mokshasoft/hus/finputs-lera.md

# Lergolv och finputs med lera
Process och recept för att göra lerbadrum och lergolv.

## Leran
Det behöver vara en finkorning lera utan för mycket sand och organsiskt material. Kan man inte få tag i det så kan det köpas som lerpulver/lermjöl från tex baramineraler.se. 

## Recept finputs
Läggs som sista lagret i väggar och golv. Kan vara mellan 0,5-1.5 cm.

- 2-5% ej uppvärmd rå linolja, lägre spannet går ok pga av pris.
- kaveldun, i samma mängd som det brukar vara fibrer.

## Recept finfinputs

Ett speciallager som kan användas i badrums ytor som utsätts för mycket vatten. Ett mycket tunt lager som läggs efter finputsen.

- Filtrera en lervälling genom ett finmaskigt såll.

## Process för golvläggningen (förutom badrum)

1. Lägg ett finputslager. Låt härda.
1. Stryk golvet med uppvärmd rå linolja, cirka 80 grader, för att det lättare ska tränga ner i leran. Om temperaturen överstiger 100 polymeriseras oljan och kan då inte trängas ner i leran.
1. Låt härda i 10 dagar.
1. Stryk golver med uppvämd rå linolja.
1. Låt härda i 10 dagar.
1. Slipa med en fyrkantig cementgolvslip. Det gör att sandpartiklar som sticker upp ur ytan försvinner och resultatet blir en väldigt slät yta.
1. Upprepa strykning med uppvärmd rå linolja/härdning 2 ggr.

## Process för golv och vägg i badrum

Gör samma process som för andra golv, och lägg till ett lager finfinputs efter finputslagret. Sedan följande process:

1. Stryk med två lager kokt linolja, med härdning mellan.
1. Stryk ett lager standolja (Standolja är en polymeriserad kokt linolja). Det ger bättre vatten avvisning. Ta ej för mycket eftersom det tar lång tid att torka.
