mokshasoft/hus/gen/hus4.stl

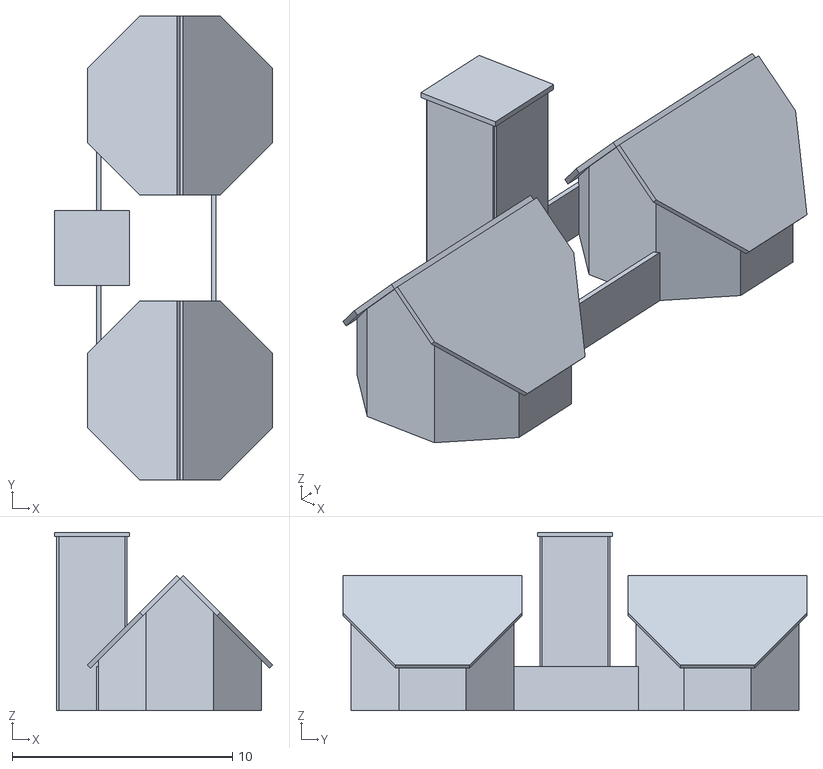
[picture p1: CAD file, 2025-08-23]
gen/hus4.stl
9.91 x 21.1 x 8.10
