mokshasoft/hus/gen/greenhouse1.stl

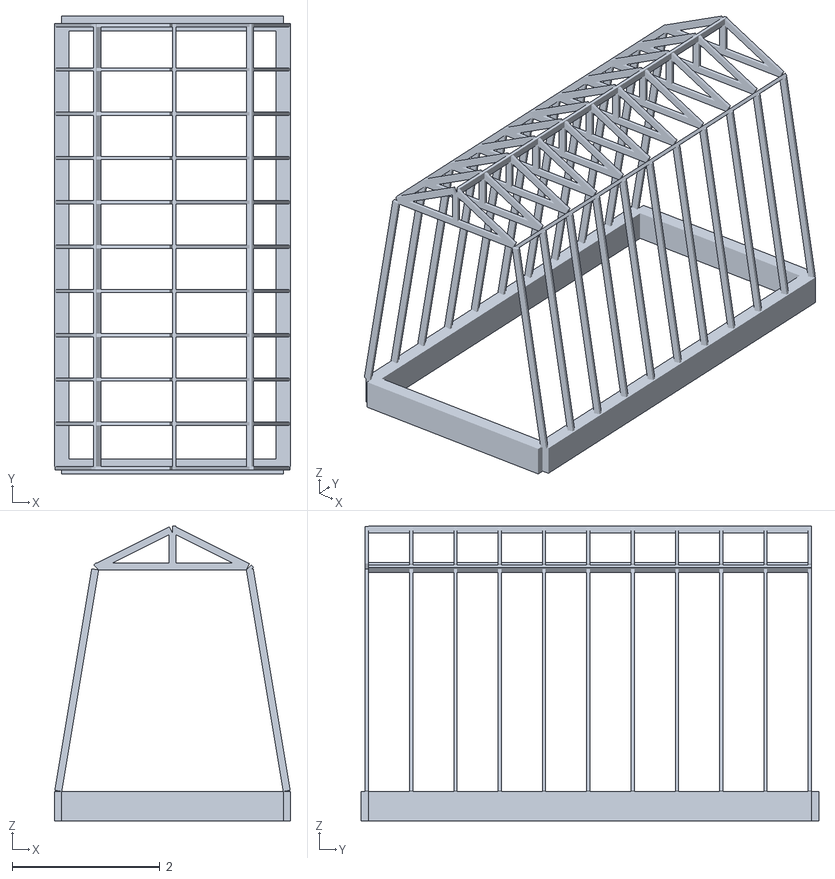
[picture p2: CAD file, 2025-08-23]
gen/greenhouse1.stl
3.20 x 6.20 x 4.00
