mokshasoft/hus/gen/hus5.stl

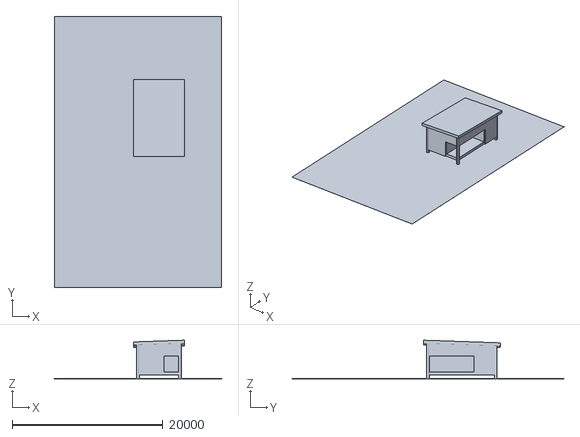
[picture p3: CAD file, 2025-08-23]
gen/hus5.stl
22249.2 x 36000.0 x 5137.5
