mokshasoft/hus/gen/hus6.stl

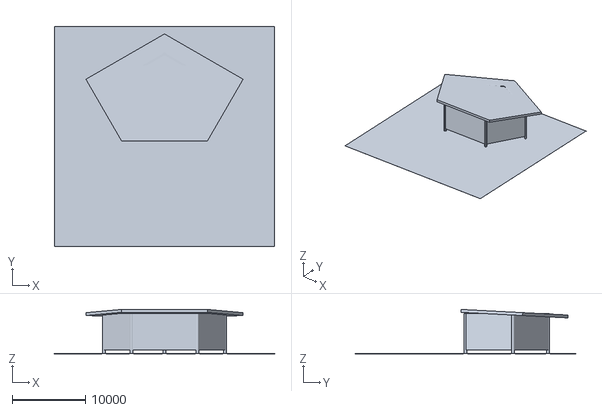
[picture p4: CAD file, 2025-08-23]
gen/hus6.stl
30080.0 x 30080.0 x 6042.1
