mokshasoft/hus/gen/guesthouse1.stl

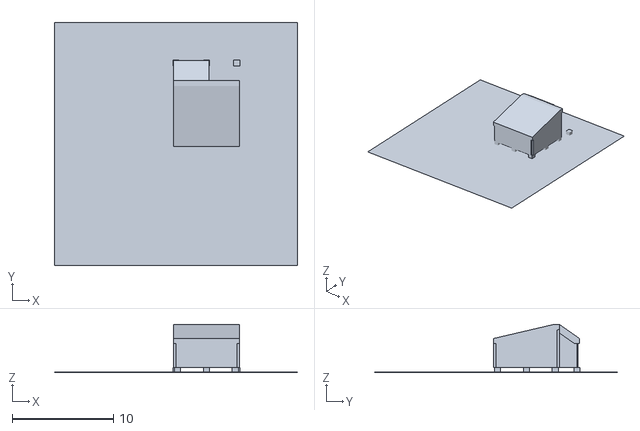
[picture p5: CAD file, 2025-08-23]
gen/guesthouse1.stl
24.0 x 24.0 x 4.77
