mokshasoft/hus/gen/greenhouse2.stl

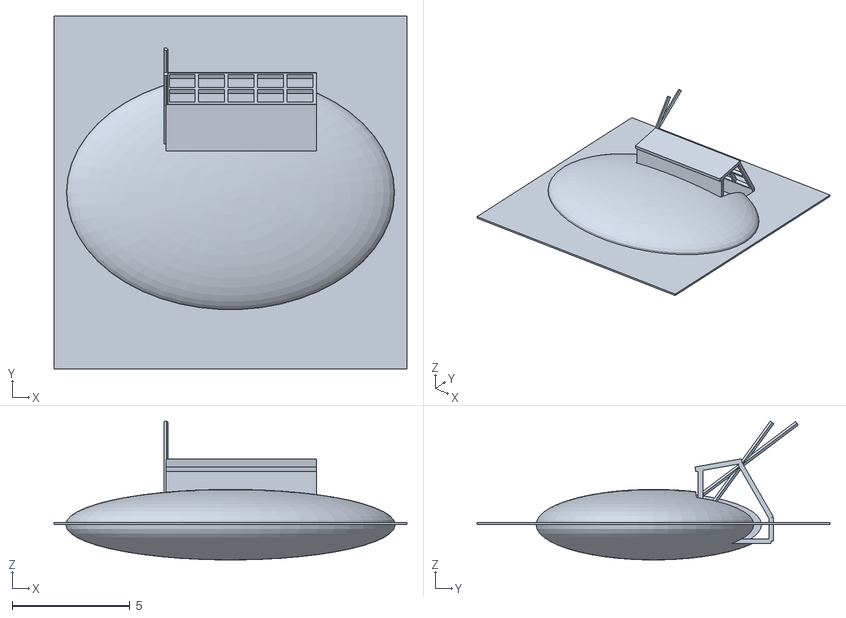
[picture p6: CAD file, 2025-08-23]
gen/greenhouse2.stl
15.0 x 15.0 x 5.90
