mokshasoft/hus/gen/hylla-kontor.stl

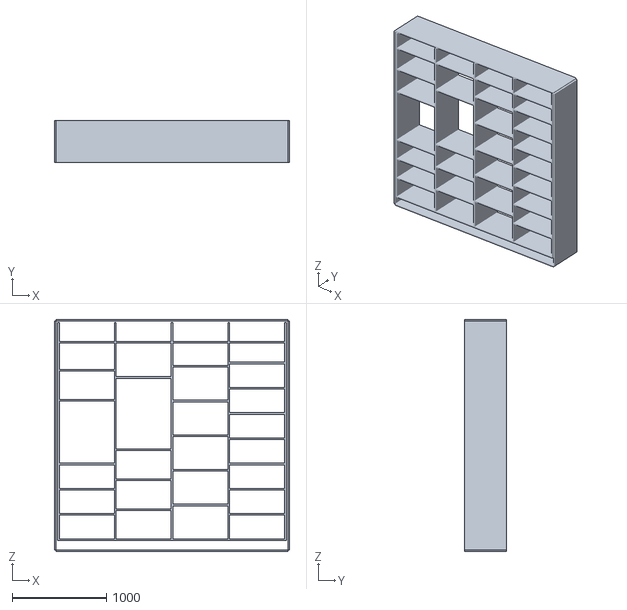
[picture p7: CAD file, 2025-03-01]
gen/hylla-kontor.stl
2496.0 x 450.0 x 2466.0
