mokshasoft/hus/gen/hus8.stl

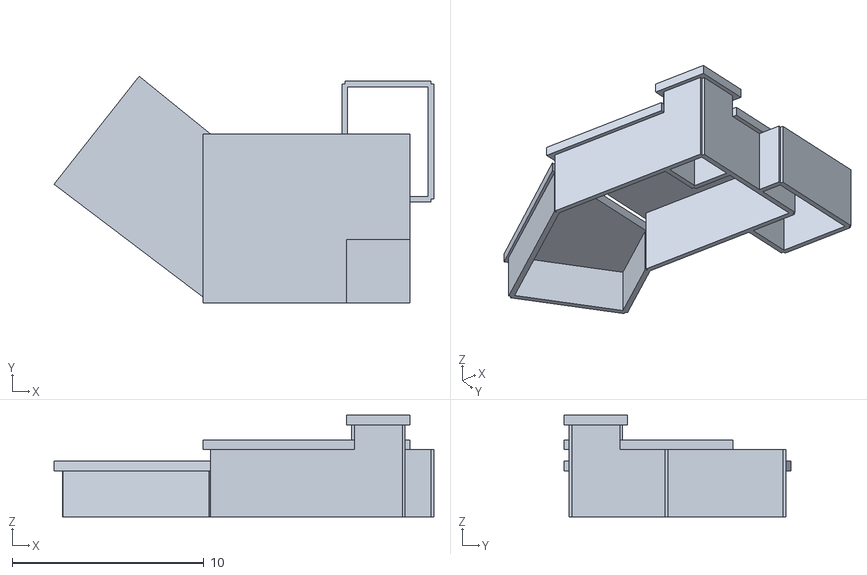
[picture p8: CAD file, 2021-03-17]
gen/hus8.stl
19.8 x 11.8 x 5.30
