mokshasoft/hus/gen/hus7.stl

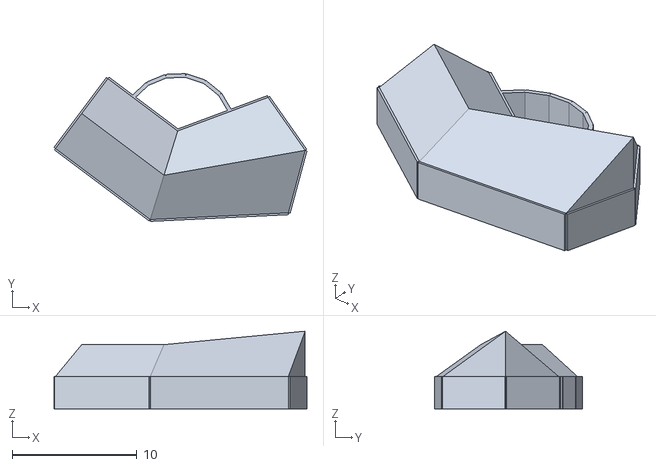
[picture p9: CAD file, 2020-10-30]
gen/hus7.stl
20.3 x 11.9 x 6.23
