mokshasoft/hus/gen/guesthouse2.stl

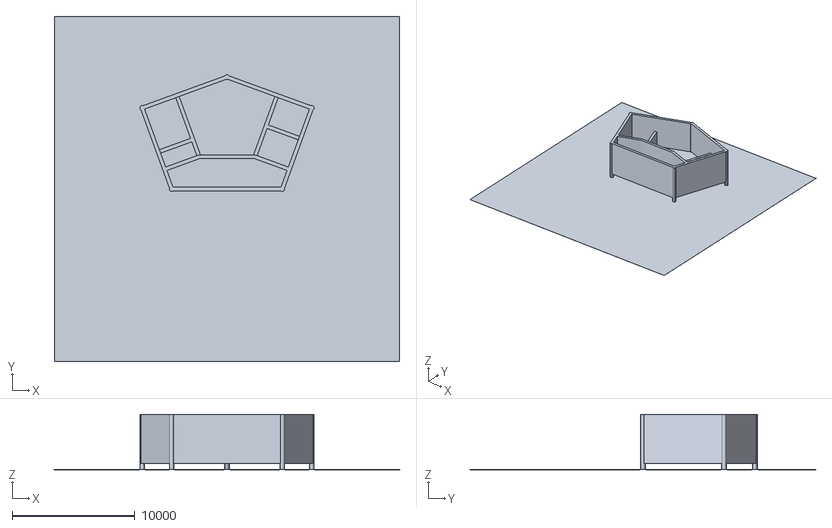
[picture p10: CAD file, 2020-05-02]
gen/guesthouse2.stl
28080.0 x 28080.0 x 4502.0
