mokshasoft/hus/gen/hus3.stl

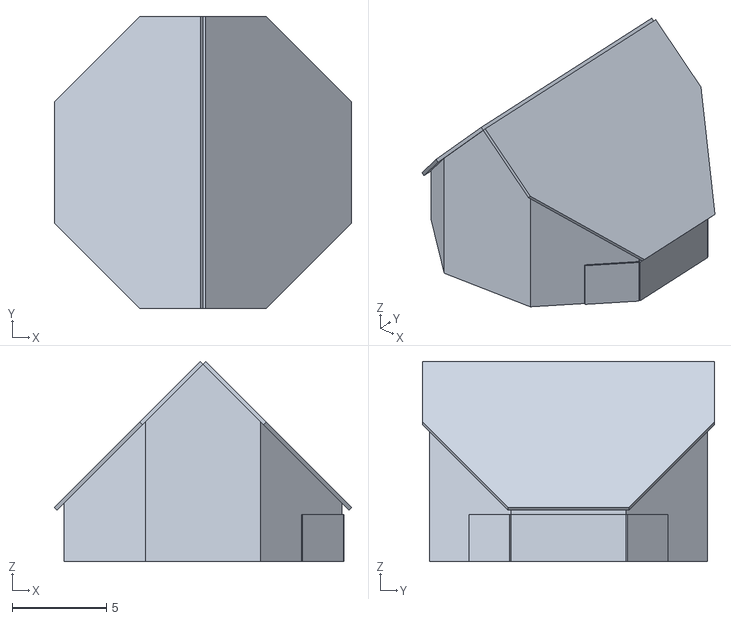
[picture p11: CAD file, 2019-09-15]
gen/hus3.stl
15.8 x 15.5 x 10.6
