mokshasoft/hus/gen/hus1.stl

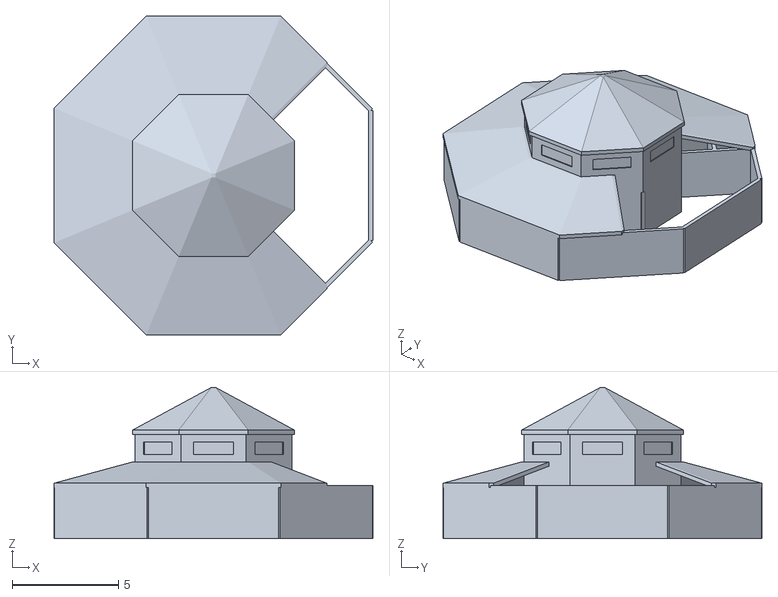
[picture p12: CAD file, 2019-09-15]
gen/hus1.stl
15.0 x 15.0 x 7.10
