mokshasoft/hus/gen/hus2.stl

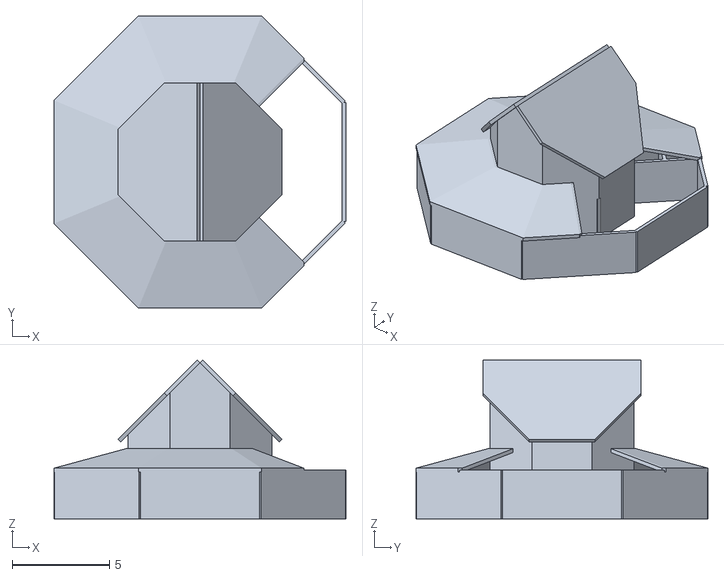
[picture p13: CAD file, 2019-09-15]
gen/hus2.stl
15.0 x 15.0 x 8.14
