mokshasoft/hus/gen/plan1_2.stl

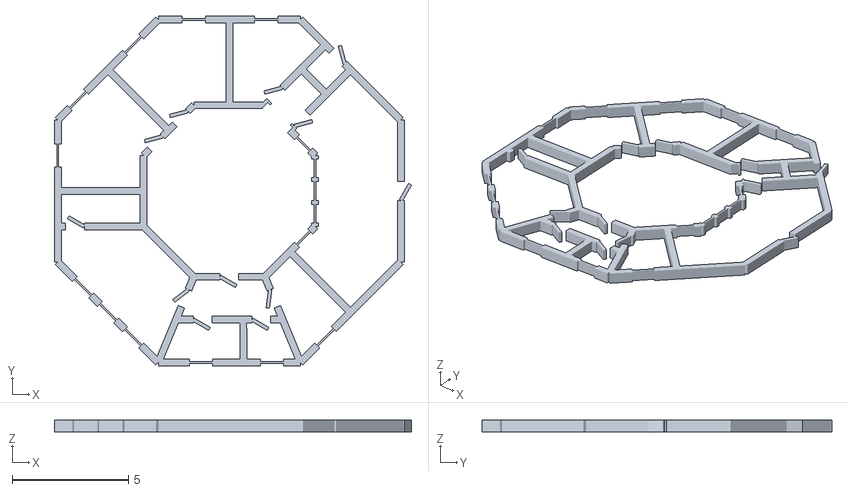
[picture p14: CAD file, 2019-09-12]
gen/plan1_2.stl
15.4 x 15.1 x 0.5
