mokshasoft/hus/gen/plan1_1.stl

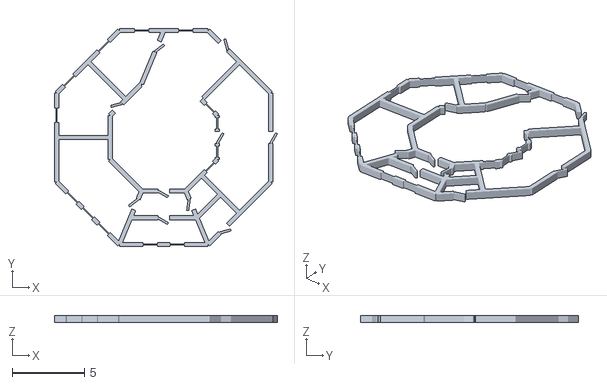
[picture p15: CAD file, 2019-09-12]
gen/plan1_1.stl
15.4 x 15.1 x 0.5
