mokshasoft/hus/gen/utan-tak.stl

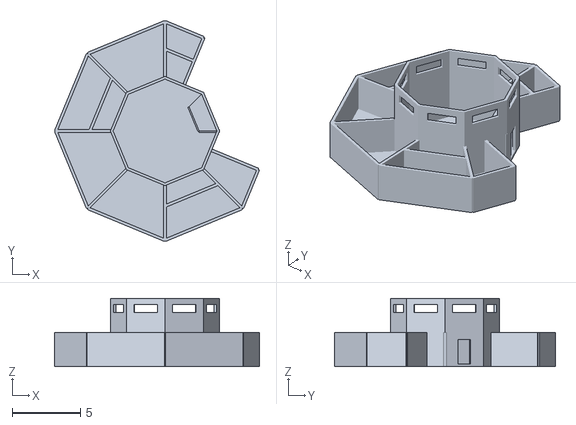
[picture p16: CAD file, 2019-09-09]
gen/utan-tak.stl
15.0 x 16.2 x 5.00
