mokshasoft/hus/(list of files, cad)

Other CAD files:
hus1-plan.scad
hus2.scad
hus3.scad
plan1_1.scad
