mokshasoft/hus/Elements/ChangeLog.md

# Changelog for Elements

## Unreleased changes
