mokshasoft/hus/(commit log)

2019-09-08 The basic structure of the house
    [hus1.scad]
2019-09-08 Add windows to main room
    [hus1.scad]
2019-09-08 Add glass to windows
    [hus1.scad]
2019-09-08 Create hole for front door
    [hus1.scad]
2019-09-08 Make the roof in the main room sloping
    [hus1.scad]
2019-09-08 Slope the outer roof
    [hus1.scad]
2019-09-08 Slope the left and right outer roofs
    [hus1.scad]
2019-09-09 The first room design
    [hus1.scad]
2019-09-09 Add generated stl files
    [med-tak.stl, utan-tak.stl]
2019-09-10 Create the start of the first floor plan
    [plan1.scad]
2019-09-10 Add final doors to first plan of house 1
    [plan1.scad]
2019-09-10 Fixed rendering problem in glas wall of winter garden
    [plan1.scad]
2019-09-11 Add more windows to plan1
    [plan1.scad]
2019-09-12 Add second floor plan example
    [hus1-plan.scad, plan1_1.scad, plan1_2.scad]
2019-09-12 Generate stl files instead of png files for floor plan
    [plan1_1.stl, plan1_2.stl]
2019-09-12 Add windows to bathrooms
    [plan1_2.scad, plan1_2.stl]
2019-09-14 Create and use a window module
    [hus1.scad]
2019-09-15 Add a house with a 45 degree slooping roof towards the south
    [hus1.stl, hus2.scad, hus2.stl]
2019-09-15 Removed med-tak.stl
    [med-tak.stl]
2019-09-15 Add start of third house model
    [hus3.scad, hus3.stl]
2019-09-19 Broke out wall creation etc to element.scad
    [element.scad, hus1.scad]
2019-09-19 Use element.scad for hus2 and hus3
    [hus2.scad, hus3.scad]
2019-09-19 Assemble the house in two modules
    - One for the house
    - One for the interior
    [hus1.scad]
2019-09-19 Broke out the glas color to element.scad and changed it to lightblue
    [element.scad, hus1.scad, hus2.scad, hus3.scad]
2019-09-19 Use mirror instead of writing two mirrored models
    [hus1.scad]
2020-03-19 Start the fourth house
    [hus4.scad]
2020-03-19 Create the left and right side of house 4
    [hus4.scad]
2020-03-19 Add central walls
    [hus4.scad]
2020-03-19 Add a tower to the house
    [hus4.scad]
2020-04-12 Add two guesthouses
    [element.scad, guesthouse.scad, guesthouse2.scad]
2020-04-13 Make colors into modules
    [element.scad, guesthouse2.scad]
2020-04-13 Use the standard colors for the first guesthouse
    [guesthouse.scad]
2020-04-13 Add colors to second house
    [hus2.scad]
2020-04-13 Add colors to house one
    [hus1.scad]
2020-04-16 Make guesthouse2 slightly larger
    [guesthouse2.scad]
2020-04-16 Add area calculations to guesthouse2
    [area.scad, guesthouse2.scad]
2020-04-18 Rearrange inner walls
    [guesthouse2.scad]
2020-04-18 Add loft area calculation
    [guesthouse2.scad]
2020-04-21 Add length measurements to guesthouse2
    [guesthouse2.scad, measurement.scad]
2020-04-26 Measure other lengths on guesthouse in order to be able to stake it out
    [guesthouse2.scad]
2020-05-02 Add stl file of guesthouse2
    [guesthouse2.stl]
2020-05-03 Create floorplan for guesthouse2
    [floorplan.scad, guesthouse2-plan.scad]
2020-05-04 Increase the size of guesthouse2
    [guesthouse2.scad]
2020-05-04 Use the configuration of guesthouse2 in the floorplan
    [guesthouse2-plan.scad]
2020-05-04 Make the inner walls thinner on guesthouse2
    [guesthouse2-plan.scad]
2020-05-04 Make the hall 2m's wide in guesthouse2
    [guesthouse2-plan.scad, guesthouse2.scad]
2020-05-04 Add material calculations for guesthouse2
    [guesthouse2.scad]
2020-10-10 Move helper files to lib
    [guesthouse.scad, guesthouse2.scad, hus1.scad, hus2.scad, hus3.scad, hus4.scad]
2020-10-26 Starting the 7th house
    [hus7.scad]
2020-10-27 Remove hard-coding of corners in 7
    [hus7.scad]
2020-10-27 Print the south angle
    [hus7.scad]
2020-10-27 Open up the south angle a bit
    [hus7.scad]
2020-10-27 Calculate volume of insulation of 7
    [hus7.scad]
2020-10-27 Remove unused code in 7
    [hus7.scad]
2020-10-27 Add winter garden
    [hus7.scad]
2020-10-27 Make more space in left side
    [hus7.scad]
2020-10-27 Make right side shorter to make the house smaller
    [hus7.scad]
2020-10-27 Remove unused code
    [hus7.scad]
2020-10-27 Make 7 a floor plan
    [hus7.scad]
2020-10-28 Add calculation of winter garden area
    [hus7.scad]
2020-10-30 Remove incorrect glas_color
    [hus2.scad, hus3.scad, hus7.scad]
2020-10-30 Add beams for the top of the roof
    [hus7.scad]
2020-10-30 Add the roof
    [hus7.scad]
2020-10-30 Remove the beams
    [hus7.scad]
2020-10-30 Lower the roof angle
    [hus7.scad]
2020-10-30 Add height of the lower roof-ridge
    [hus7.scad]
2020-10-30 Place the highest roof ridge in the correct spot
    [hus7.scad]
2020-10-30 Add walls up to the roof-ridge
    [hus7.scad]
2020-10-30 Add measurement of roof-ridge heights
    [hus7.scad]
2020-10-30 Add more scad files to stl target
2020-10-30 Add hus7 stl
    [hus7.stl]
2020-11-27 Remove the ridge on the roof in house 7
    [hus7.scad]
2020-11-28 Change roof angle to 10 degrees
    [hus7.scad]
2021-03-17 Copied hus7
    [hus8.scad]
2021-03-17 Start on hus8
    [hus8.scad]
2021-03-17 Add tea room roof
    [hus8.scad]
2021-03-17 Add lower roof
    [hus8.scad]
2021-03-17 Add the living room roof
    [hus8.scad]
2021-03-17 Add stl for hus8
    [hus8.stl]
2021-08-20 Start a model of the guesthouse
    [guesthouse1.scad]
2021-08-21 Add foundation on guesthouse
    [guesthouse1.scad]
2021-08-21 Parameterize where plinths are places in guesthouse
    [guesthouse1.scad]
2021-08-22 Add foundation for the south patio
    [guesthouse1.scad]
2021-08-22 Add outer roof
    [guesthouse1.scad]
2021-12-09 Start on the garage
    [garage1.scad]
2021-12-14 Add roof and trellis walls
    [garage1.scad]
2021-12-14 Add flat walls
    [garage1.scad]
2021-12-14 Triangle walls and color
    [garage1.scad]
2021-12-14 Add more color
    [garage1.scad]
2021-12-14 Configure log diameter
    [garage1.scad]
2021-12-15 Make garage more parameterized
    [garage1.scad]
2021-12-15 Start on the greenhouse
    [greenhouse1.scad]
2021-12-15 Add lengthwise beams
    [greenhouse1.scad]
2021-12-15 Moved configuration to top
    [greenhouse1.scad]
2022-01-02 Add greenhouse truss
    [greenhouse1.scad]
2022-01-28 Add foundation
    [foundation.scad]
2022-04-03 Add roof length calculation
    [garage1.scad]
2022-04-03 Add modules used to calculate material amounts
2022-04-05 Start a material calculation
2022-04-06 Add the rest of the framed walls
2022-04-06 Print lengths of all materials
2022-04-07 Redo the foundation with natural stones
    [foundation.scad]
2022-04-07 Remove hard coding of outer size
    [foundation.scad]
2022-04-07 Add log foundation
    [foundation.scad]
2022-04-07 Change color
    [foundation.scad]
2022-04-07 Create the floor framework
    [foundation.scad]
2022-04-08 Do not buy material for the winter garden and garage for now
2022-04-24 Add material for floor framework
2022-08-25 Fix a length measurement on the garage
    [garage1.scad]
2023-01-22 OpenSCAD stove test
    [compose.scad, stove1.scad]
2023-01-22 Add more stove composers
    [compose.scad, stove1.scad]
2023-01-31 Use correct brick sizes
    [compose.scad, stove1.scad]
2023-02-09 Tried some stove things
    [compose.scad, stove1.scad]
2023-05-21 hindent Materials
2023-10-27 Started the rocket stove design
    [rocket-stove.scad]
2023-12-13 Update materials for carport
2024-04-10 Test a new house shape
    [hus9.scad]
2024-04-11 Achieve golden ratio with 10 sides
    [hus9.scad]
2024-04-11 Find height for 11 sides
    [hus9.scad]
2024-04-14 Parameterize the number of floors
    [hus9.scad]
2024-04-14 Pass params to floor
    [hus9.scad]
2024-05-30 Skapa spaljen
    [spalje.scad]
2024-09-19 Calculate coordinates for trellis
    [spalje2.scad]
2025-01-04 Start bed design
    [bed.scad]
2025-01-04 Add bed feet
    [bed.scad]
2025-01-04 Bed done
    [bed.scad]
2025-01-05 Add floor
    [hus9.scad]
2025-01-05 Add log of bed materials
    [bed.scad]
2025-01-05 Testing different trellis configs
    [spalje2.scad]
2025-01-08 Start designing the office shelf
    [hylla-kontor.scad]
2025-01-08 Fixing off-by-one error in shelf
    [hylla-kontor.scad]
2025-01-14 Set outer dim on shelf
    [hylla-kontor.scad]
2025-01-27 List comprehend shelves
    [hylla-kontor.scad]
2025-01-27 Move width to top-level
    [hylla-kontor.scad]
2025-01-27 Make the correct width
    [hylla-kontor.scad]
2025-01-27 Add opening
    [hylla-kontor.scad]
2025-01-27 Make shelf columns uniform and parameterized
    [hylla-kontor.scad]
2025-01-27 Create base
    [hylla-kontor.scad]
2025-01-27 Move bottom shelf to base
    [hylla-kontor.scad]
2025-01-27 Make shelves correct width
    [hylla-kontor.scad]
2025-01-27 Add top shelf height
    [hylla-kontor.scad]
2025-01-29 Accumulate shelf positions
    [hylla-kontor.scad]
2025-01-29 Design done
    [hylla-kontor.scad]
2025-01-29 Print number of planks
    [hylla-kontor.scad]
2025-02-03 First spa concept
    [spa.scad]
2025-02-03 Try fixing rendering
    [spa.scad]
2025-02-04 Simplify roof
    [spa.scad]
2025-03-01 Hylla stl
    [hylla-kontor.stl]
2025-03-09 Finish shelf design
    [hylla-kontor.scad]
2025-03-09 Add functions that print measurments
    [hylla-kontor.scad]
2025-03-09 Print measurment in model
    [hylla-kontor.scad]
2025-05-15 Use 15 sticks
    [bed.scad]
2025-08-19 Create a second greenhouse
    [greenhouse2.scad]
2025-08-20 Done with greenhouse2 concept
    [greenhouse2.scad]
2025-08-23 Try with 5 windows
    [greenhouse2.scad]
2025-08-23 Generate a few more stl:s
    [greenhouse1.stl, greenhouse2.stl, guesthouse1.stl, hus4.stl, hus5.stl, hus6.stl]
2026-04-13 Lägg till OpenSCAD-modell av huset
    Modulär modell med pulpettak (11°), inglasad veranda
    och takutskjut (50 cm hus, 20 cm veranda).
    [house.scad]
2026-04-13 Lägg till terrass med trappsteg
    Terrass på västra sidan med 19 plankor (2x8), förbindelse
    till verandan, samt trappsteg söderut med tre nivåer och
    sättsteg mellan nivåerna.
    [house.scad]
2026-04-13 Lägg till staket på terrassens västra och norra sida
    Svart staket i 2x2 med 2x4 räcke ovanpå. Låg del (1.1 m)
    med 10 cm öppning, hög del (2.2 m) med halva cc-avståndet.
    Övergång 3 meter från norr.
    [house.scad]
2026-04-13 Uppdatera färger till organowood och bränt trä
    Huset och terrassen i ljus silvergrå organowood-färg,
    staketet i mörkbrun bränt trä-färg.
    [house.scad]
2026-04-13 Lägg till variabel för att växla staketets höga del
    railing_high_horizontal styr om den höga delen har
    liggande (true) eller stående (false) reglar.
    [house.scad]
2026-04-13 Ändra räcket till 2x4 dimension
    Räcket ovanpå staketet är nu 100mm brett (4 tum)
    istället för 50mm, centrerat över stolparna.
    [house.scad]
2026-04-13 Lägg till variabler för stolparnas längd under terrassen
    railing_below_west och railing_below_north styr hur
    långt stolparna sträcker sig under terrassnivån.
    Båda satta till 60 cm.
    [house.scad]
2026-04-22 Lägg till skiss av vedskjul med parametriserat pulpet-tak
    Bygger 10x1,5 m vedskjul av 2x8 med parametrar för längd, djup,
    antal sektioner, vägghöjd, takvinkel och takutsprång. Hörnen har
    V-stolpar och sektionsavdelare T-stolpar, alla med höjder anpassade
    efter takets lutning. En kanonisk tum2x8-modul skriver ECHO-rader
    som kan parsas fram till en virkeslista.
    [vedskjul.scad]
2026-05-03 Logga åtgång av 2x2 till räcket
    [house.scad]
2026-05-03 Omarbeta vedskjulet: 6 sektioner á 1,5 m, ta bort takläkten
    Lägg också till echo för fri höjd fram/bak och golvhöjd.
    [vedskjul.scad]
2026-07-27 Bygg om räcket med bärande 2x4-stolpar och räcke på trappan
    Räcket bestod tidigare bara av jämnt utspridda 2x2. Nu delas varje sträcka
    in i fack med bärande 2x4-stolpar emellan, och räcket fortsätter ner för de
    två lägre trappstegen.
    - Ny modul railing_section() som delar en sträcka i fack. Antalet fack väljs
    så att facklängden hamnar närmast önskad, sedan justeras öppningen så att
    sektionen går jämnt ut — inga kapade halvfack i änden.
    - 2x4-stolparna är vridna 90°, dvs 100 mm tvärs räcket och 50 mm längs, och
    centreras över 2x2-linjen i liv med den liggande handledaren.
    - 2x4 sitter i början, vid övergången låg/hög, i det höga hörnet och mot
    h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
    [house.scad]
2026-07-27 Lägg till räcke på trappans östra kant
    Trappstegen går från terrassens västra kant ända fram till verandans östra
    vägg, men bara västra kanten hade räcke. Östra kanten speglas nu kring
    trappans mittlinje, x -> step_mirror_dx - x.
    Östsidan har tre nivåer i stället för två: terrassens sydkant är lika djup
    som ett trappsteg (620 mm, tre plankor) och får ett eget räcke via samma
    railing_step(). I väster täcks den nivån av terrassräckets låga del, som
    fortsätter norrut. Handledaren där avslutas mot verandans södra vägg.
    Bottenregeln ritas också på östsidan, eftersom det inte finns någon
    genomgående sådan att ansluta till där.
    [house.scad]
2026-07-27 Rita utbyggnaden i sydöstra hörnet
    Byggnaden går ut 1,7 m åt öst på sydöstra sidan, 3,1 m i nord-sydlig
    riktning (husets djup minus 5,2 m) räknat från södra väggen.
    Taket ligger i samma plan som huvudtaket och har samma utsprång på de tre
    exponerade sidorna. I väster går det rakt in till house_width, där det möter
    huvudtakets utsprång — ytorna är koplanära så överlappet syns inte.
    Takplanet är utbrutet i funktionen roof_z(y), så att utbyggnadens tak och
    väggarnas överkant inte kan hamna ur liv med huvudtaket.
    [house.scad]
2026-07-27 Lägg till terrass öster om huset, norr om utbyggnaden
    Terrassen fyller den tomma delen av L-et: x 10,2 till 11,9 och y 3,1 till
    8,3, alltså 1,7 x 5,2 m. Plankorna går i nord-sydlig riktning med 2x8 som
    på västsidan, och ovansidan ligger på samma nivå, z = 1,05.
    Bredden är låst av utbyggnaden till 1700 mm, vilket inte går jämnt upp med
    200 mm-plankor och 10 mm mellanrum. Mellanrummet justeras därför till
    14,3 mm så att 8 plankor fyller bredden exakt, i stället för att lämna en
    30 mm stump vid kanten.
    [house.scad]
2026-07-27 Lägg till räcke på östra terrassen
    Tre sektioner: en 50 cm stump norrut från utbyggnadens vägg längs östra
    kanten, norra kanten från husets nordöstra hörn och österut, samt östra
    kanten 3 m söderut från hörnet. Mellan de två östra blir det en 1,7 m
    öppning. Hörnstolpen hör till östra sektionen, den norra går fram till den.
    Ett fast antal 2x2 per fack fungerar inte här: åtta 50 mm-stolpar fyller
    exakt de 400 mm som finns i halvmeterstumpen och ger noll öppning. Ny
    railing_section_fit() räknar därför ut antalet från fackets bredd, vilket
    ger 100,0 / 97,5 / 107,5 mm mot terrassräckets 91,0 mm.
    [house.scad]
2026-07-27 Lägg till trappa från östra terrassen, dimensionerad efter trappformeln
    Trappan ligger i öppningen mellan räckessektionerna på östra terrassen och
    går ner till marken. Planstegen är 2x8, ett per steg.
    Dimensionerad efter trappformeln, 2 x stighöjd + steg = 600-640 mm, i
    stället för att kopiera lutningen från trappan i söder. Den gav 200 mm steg
    med 95 mm stigning, alltså summan 390 mm — långt under intervallet och
    obekvämt att gå i.
    Antalet 2x8 per plansteg är den enda fria variabeln eftersom brädbredden är
    given, och styrs av stair_east_boards. Med 1 bräda blir det 4 plansteg,
    210 mm stigning, 46,4 grader och summan 620 mm. Med 2 brädor blir det
    9 plansteg, 105 mm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
    [house.scad]
2026-07-27 Lägg till räcke på båda sidor om trappan
    Handledaren är en 2x4 roterad kring sin övre ände, så att undersidan ligger
    railing_height_low lodrätt över gånglinjen hela vägen ner. Roteras den kring
    sin egen axel i stället blir höjden mätt vinkelrätt mot lutningen, vilket ger
    för låg höjd. 2x2 står lodrätt mellan gånglinjen och handledaren och blir
    därför lika långa allihop.
    Överst behövs ingen ny stolpe: terrassräckets ändstolpe står redan där och
    dess topp ligger på samma höjd som handledarens övre ände.
    Rättar också två fel i materiallistan: den lutande handledaren räknades som
    bottenregel, och trappräckets 2x2 saknades helt i kaplistan. Summorna
    stäm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
    [house.scad]
2026-07-27 Skjut ut trappan österut och lägg till ramp från norr
    Trappan är parallellförskjuten en bit österut och glappet fylls av en
    utskjutande terrassdel — en tunga lika bred som räckesöppningen. Tungan läggs
    med samma plankdelning som resten av östra terrassen, så utskjutet följer av
    antalet plankor i stället för tvärtom; annars hade tungan fått ett eget
    mellanrum och delningen brutit mot däcket innanför. Fem plankor ger 1,071 m,
    alltså ungefär den meter som var önskemålet.
    Rampen ligger i remsan närmast öster om terrassens ursprungliga kant och går
    från marken vid husets nordvägg upp till tungans norra kant. Lutningen följer
    av utrymmet i stället för tvärtom: det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
    [house.scad]
2026-07-27 Revert "Skjut ut trappan österut och lägg till ramp från norr"
    Designen sparas i historiken men tas ur modellen igen — den blev inte som
    tänkt. Den mesta orsaken är lutningen: kravet att rampen ska hålla sig innanför
    husets nordvägg lämnar bara 3 m åt 1,05 m fallhöjd, och 1:2,86 är för brant för
    att rampen ska göra den nytta den var tänkt att göra.
    Vill man ta upp tråden igen ligger den i f625eee. Det som behöver lösas först
    är var de saknade metrarna ska tas ifrån: låta rampen passera nordväggen,
    vika den med vilplan, eller dra tungan söderut så rampen får hela husdjupet.
    This reverts commit f625eee.
    [house.scad]
2026-07-28 Lägg till tak över östra terrassen
    Taket går från utbyggnadens norra vägg och norrut, en halvmeter under
    takutskjutet ovanför, och lutar med husets taklutning fast mot norr.
    Utskjutet österut är lika långt som på resten av byggnaden och i norr
    sticker det ut 30 cm förbi stolpen som bär det fria hörnet.
    Stommen är 2x6: fem takreglar i fallets riktning, väggregel mot
    utbyggnaden och bärlina över stolpen, båda utkragade i östra kanten.
    Ovanpå ligger en takskiva på 22 mm, och stolpen är 6x6.
    Räcket längs östra kanten slutar nu mot takstolpen i stället för att
    gå 3 meter söderut, så trappöppningen sträcker sig ända fram dit.
    Räcket på östra terrassen står d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
    [house.scad]
2026-08-04 Dra bottenregeln på trappans östra sida ända fram till väggen
    Regeln slutade vid deck_south_y + railing_big_along, dvs 5 cm in på
    översta nivån, så stolpfötterna i den sektionen stod i luften. Nu går den
    ända till verandans södra vägg, precis som den genomgående regeln i väster
    går till husväggen.
    [house.scad]
2026-08-04 Räkna ut hur många hela längder virke som går åt
    Kaplistan säger hur många bitar som behövs, men virket köps i hela
    längder. Packar bitarna med first fit decreasing och skriver ut
    kapmönstren, antal längder och spill. Bitar längre än en hel längd delas
    upp i hela längder plus en stump — de måste skarvas ändå.
    Med 4,8 m-virke: 75 st 2x2 och 20 st 2x4.
    [house.scad]
2026-08-05 Vänd golvytan i huset och utbyggnaden åt rätt håll
    Golvet var vänt tvärtemot formernas fem övriga ytor, så polyhedern aldrig
    blev sluten. Det gav de två "mesh is not closed"-felen vid rendering, och
    gjorde att difference() mot formerna returnerade tomt — vilket märks först
    nu när väggarna ska gröpas ur. Takplattorna i filen använder redan
    [3,2,1,0] för undersidan; golvet var det som avvek.
    [house.scad]
2026-08-05 Sätt in fönster i husmodellen
    Måtten i window_list är hålets mått i väggen. Fönstret görs 15 mm mindre
    runt om, och glaset ligger 50 mm innanför karmens ytterkant. Karmens
    yttermått och glasets fria mått räknas fram och skrivs ut i konsolen som
    underlag för beställning.
    Huset var en solid kloss utan väggtjocklek, så det finns inget hål att
    sätta ett fönster i. Väggen är nu 550 mm och huset gröps ur, på samma
    sätt som porch() redan gjorde.
    Fönstren som ligger i listan är platshållare tills riktiga mått finns.
    render(convexity) på väggarna behövs för snabbpreviewen: den ritar
    difference() med djuptest och måste veta hur många ytor en blick korsar.
    Utan det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
    [house.scad]
2026-08-05 Lägg bjälklaget i liv med terrassen
    Golvet låg tidigare med ovansidan 0,55 m över mark, en halvmeter under
    terrassen, så man hade fått kliva ner för att gå in. Nu ligger färdigt golv
    på deck_top_z och man går rakt ut. Huskroppens yttre form är oförändrad —
    det är hålrummet som börjar högre upp, så bjälklaget hamnar mellan 0,50 och
    1,05 m och det som blir kvar under det är grund.
    house_floor_z definieras vid deck_top_z och inte bland väggparametrarna,
    eftersom terrassmåtten kommer först där i filen.
    [house.scad]
2026-08-05 Vita fönsterkarmar och fönsterhöjder över färdigt golv
    Karmen fick en egen färg i stället för att dela fasadens organowood.
    Höjden i window_list räknas nu från färdigt golv i stället för från mark,
    vilket är så fönsterhöjder brukar anges. window_place lägger på
    house_floor_z, så platshållarna är tillbaka på 0,9 respektive 1,1 m —
    samma läge som förut, mätt från den nya referensen.
    [house.scad]
2026-08-05 Lägg in nordfasadens tre första fönster med riktiga mått
    Fasadritningen ses utifrån, så "höger" i vyn är västra gaveln, x = 0.
    n_x() räknar om det uppmätta avståndet till hålets högra kant till den
    mittlinje som window_list vill ha, så måtten står kvar som de mättes.
    Fönstren placeras relativt varandra i stället för med varsitt absolutmått:
    det övre av paret utifrån mellanrummet till det undre, det tredje utifrån
    avståndet i sidled till paret och med hålets överkant i liv med dem.
    Platshållarna för syd, väst och öst ligger kvar i en egen lista tills de
    väggarna mäts in.
    [house.scad]
2026-08-05 Visa hålets hela höjdintervall i fönsterlistan
    Utskriften gav bara underkanten, vilket gjorde att liv mellan fönster inte
    gick att läsa av. Nu skrivs underkant-överkant, t.ex. "hålet 600-1810 mm
    ö golv", så att fönster som ska ligga i liv går att kontrollera direkt.
    [house.scad]
2026-08-05 Utgå från grundstommen och lägg skalet utanpå
    Måtten som tas på bygget avser grundstommens liv, medan modellens fasadliv
    är panelens utsida. Emellan ligger 6 cm vindskydd, 5 cm luftspalt och 3 cm
    panel. Skillnaden är nu en parameter, wall_utanfor_stomme, och tillämpas på
    tre ställen:
    Fönsterlägena på nordfasaden skjuts ett skikt inåt. Tillägget görs i n_x(),
    så hela paketet flyttas lika mycket och de inbördes avstånden är orörda.
    Husets yttermått räknas från stommens 10050x8150 plus ett skikt per sida,
    alltså 10.33 x 8.43. De tidigare 10.2 x 8.3 gick inte ihop med stommåtten:
    skillnaden var 150 mm i båda led, vilket varken motsvarar ett skikt eller
    två. De var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
    [house.scad]
2026-08-05 Lägg in västfasadens fönster och glasdörr
    Tre fönster och en glasdörr, med samma referens som norr: fasaden ses
    utifrån, så "höger" är söder och måtten löper från stommens södra liv.
    v_y() gör omräkningen och lägger på skalet, precis som n_x().
    Relationerna från ritningen är inbundna i stället för utskrivna som
    absolutmått: fönster 3 delar underkant med fönster 2, och glasdörren står i
    samma sidoläge som fönster 2. Fönster 3:s sidoläge är givet från norra änden
    och räknas om via frame_depth.
    window_list har fått ett valfritt sjätte fält för typ. Geometrin är
    densamma — en glasdörr är ett hål med karm och glas, bara med underkanten i
    golvnivå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
    [house.scad]
2026-08-05 Höj taket och ge det sin verkliga uppbyggnad
    Husets höjd utgick från ett fast mått på 6 m över mark. Nu räknas den från
    stommen: 4985 mm mätt från färdigt golv, alltså 6.035 över mark. Det tvingade
    upp deck_top_z och house_floor_z till Beräknade värden, eftersom golvnivån
    måste vara känd innan husets höjd kan räknas ut.
    Taket var 15 cm tjockt och är nu 51 cm isolering, 3 cm brädlager, 6 cm läkt
    och plåt — 60.1 cm. Takplanet roof_z() är fortfarande stommens överkant, så
    hela paketet reser sig därifrån och ovansidan gick från 6.15 till 6.73 m.
    Utskjutet har ingen isolering utan bärs av en stående 2x4 med samma ytskikt
    ovanpå, 19.1 cm. Plåten är gemensam o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
    [house.scad]
2026-08-05 Låt fasaden gå upp till takfotens undersida
    Isolerpaketets kant låg i liv med fasaden och syntes utifrån som ett 60 cm
    brett takfärgat band runt hela huset. I verkligheten fortsätter fasadskiktet
    upp förbi isoleringen och möter takfotens undersida, så utifrån ska man se
    vägg ända dit och bara takfoten ovanför.
    Huskroppen och utbyggnaden toppar nu wall_over_frame över takplanet, vilket
    är skillnaden mellan takets och takfotens tjocklek. Det takfärgade bandet på
    fasaden är därmed 29 cm: takfoten själv plus dess undersida sedd i lutning.
    Isolerpaketen är samtidigt indragna en väggtjocklek. Låg de kvar i liv med
    fasaden skulle två olikfärgade ytor hamna i samma plan oc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
    [house.scad]
2026-08-05 Lägg in östsidans fönster och dörr
    Ett fönster i utbyggnadens östvägg och en tät vit dörr i huvudhusets, ut
    mot östra terrassen norr om utbyggnaden.
    Utbyggnaden var en massiv kloss och hade inget hål att sätta ett fönster i.
    Den har nu samma behandling som huvudhuset: house_east_ext_shell() för den
    yttre formen, plus hålrum och fönsterhål. Hålrummet är öppet mot huvudhuset
    i väster och lämnar bara utbyggnadens tre egna väggar. Väggkoden "UO" ställer
    fönstret i utbyggnadens östliv i stället för husets.
    Måtten på den här fasaden är tagna från båda hållen — fönstret från vänster,
    dörren från höger — så östsidan har en omräkningsfunktion per rik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
    [house.scad]
2026-08-05 Lägg in sydfasadens två öppningar
    Två lika öppningar i golvnivå. Sydfasaden ses utifrån, så "höger" är öster
    och måtten löper från stommens västra liv österut.
    Den andra placeras utifrån spalten till den första i stället för med ett eget
    gavelmått, så de 360 mm hålls om den första flyttas.
    Därmed är alla platshållare borta — samtliga öppningar i modellen bygger nu
    på uppmätta stommått.
    Måtten avslöjar att verandan sitter fel: den andra öppningen ska ligga inuti
    den, men sträcker sig 262 mm väster om verandans vägg. Verandan har aldrig
    fått riktiga mått utan är ritad centrerad på huset med gissad bredd. Den
    lämnas orörd tills stommåtten finns.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
    [house.scad]
2026-08-05 Lägg in sydfasadens tredje fönster
    Placerat utifrån spalten till nummer 2, så kedjan hänger ihop hela vägen
    från stommens västra liv.
    Kedjan går dock inte ihop mot andra hållet: 1495 + 908 + 360 + 908 + 2915 +
    558 lämnar 3046 mm fram till fasadens sydöstra hörn, medan måttet på plats
    säger 2950. Var de 96 mm sitter är inte utrett.
    [house.scad]
2026-08-05 Placera verandan efter sydfasadens öppningar
    Verandan var ritad centrerad på huset med gissad bredd, vilket inte gick
    ihop med öppningarna: den andra ska ligga innanför verandan men stack ut
    262 mm väster om den.
    Läget är nu avläst ur fasaden i stället — västra väggen står i spalten
    mellan de två vänstra öppningarna, östra väggen slutar 200 mm före den
    högras vänstra kant. Måtten binds till fönsterkedjan, så verandan följer med
    om öppningarna flyttas. Bredden blir 3803 mm mot tidigare 4000.
    Sju moduler räknade ut porch_x_offset lokalt och hade skuggat den globala;
    de är borttagna. step_east_x pekar nu på verandans östra liv i stället för
    att räkna om centr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
    [house.scad]
2026-08-05 Lägg till ett fjärde fönster på nordfasaden och höj den övre raden
    Den övre raden består nu av två fönster som delar underkant och höjd. Det
    nya sitter till vänster, 675 brett, med högerkanten i liv med det stora
    fönstret under sig. Det befintliga övre behåller sin bredd och sitt sidoläge.
    Villkoren är inbundna som relationer i stället för avskrivna tal:
    underkanten hämtas ur kedjan nerifrån via mellanrummet, bredden på det
    befintliga ur n1_b, och det nyas högerkant ur n2_fran_hoger.
    Höjden delas via n_ovre_h, satt till 1210. Varje fönster har ändå sin egen
    n3_h och n4_h som pekar dit, så de går att bryta loss var för sig om de
    senare ska skilja sig åt. Unde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
    [house.scad]
2026-08-05 Rätta husets bredd — 10050 är totalmåttet, inte huvuddelen
    Ritningens 10050 avser hela byggnadens stommått i öst-väst och innehåller
    utbyggnadens utskjut på 1700. Modellen använde det som huvuddelens bredd och
    lade utbyggnaden utanpå, så huset blev 11750 i stället för 10050. Den
    nordligaste väggen är 8350; frame_width sätts till det.
    Tre oberoende observationer pekade åt samma håll och stämmer nu:
    Avståndet från nordfasadens vänstra nedre fönster till östra innerväggen går
    från 2669 till 969 mm, mot 920 uppmätt på plats.
    Väggen öster om verandan blir 2104 mm bred mot 3756 hög i stället för i
    praktiken kvadratisk, alltså tydligt högre än bred som den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
    [house.scad]
2026-08-05 Lägg in vit dörr i utbyggnadens norrvägg
    913x2115 i golvnivå, ut mot östra terrassen, 490 mm från utbyggnadens östra
    stomliv.
    Väggen vetter åt samma håll som huvudhusets nordfasad, så "vänster" i den
    vyn är öster. un_x() räknar därifrån och västerut, med referensen bunden
    till ext_frame_width i stället för ett absolut x — dörren följer med om
    utbyggnadens utskjut ändras.
    Utbyggnaden var redan urgröpt sedan östfönstret, så house_east_ext() plockar
    upp den nya öppningen automatiskt.
    Därmed är alla elva öppningar inlagda: fyra fönster i norr, tre plus glasdörr
    i väster, en dörr i huvudhusets östvägg, ett fönster och en dörr i
    utbyggnaden, och tre i s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
    [house.scad]
2026-09-13 Bryt ut staketet i norr till en egen, parametriserad fil
    Staketet står i origo med verkliga virkesmått (2x4 = 45x95, 2x2 = 48x48)
    och stolplängden 2784. Indelningen styrs av antalet 2x4 totalt och antalet
    2x2 per sektion, och öppningen blir lika stor mellan alla virken. Filen
    skriver ut en hålborrningslista med stolparnas centrum mätt från öster.
    [norr-staket.scad]
2026-09-16 Bryt ut staketet i väster till en egen, parametriserad fil
    Samma upplägg som norr-staket.scad: verkliga virkesmått, indelning styrd av
    antal virken och en hålborrningslista, här mätt från norra hörnet. Västra
    sidan har fyra nivåer — två trappsteg, låg del längs terrassen och en hög
    del i norr som är en exakt kopia av norr-sektionen. Varje nivåskillnad får
    en enda delad 2x4 i den övre nivåns höjd, och bottenregeln går genomgående
    under samtliga stolpfötter.
    Terrassens längd, trappstegens CC och nivåskillnaden är än så länge de
    nominella måtten ur house.scad och får bytas mot inmätta.
    [väst-staket.scad]
2026-09-22 Begränsa västra staketets borrlista till den låga delen
    Den höga delen borras med norr-staketets mått, så listan där fyllde ingen
    funktion. Kvar är den låga delen längs terrassen, med noll i
    övergångsstolpens södra sida — där den höga sektionen slutar — och måtten
    växande söderut.
    Stolparna plockas fortfarande ur railing_post_list, så listan och
    geometrin kan inte glida isär.
    [väst-staket.scad]
